SleepUnit/CrushCounter/1.5/gerber/OSFRD-Edge_Cuts.dxf

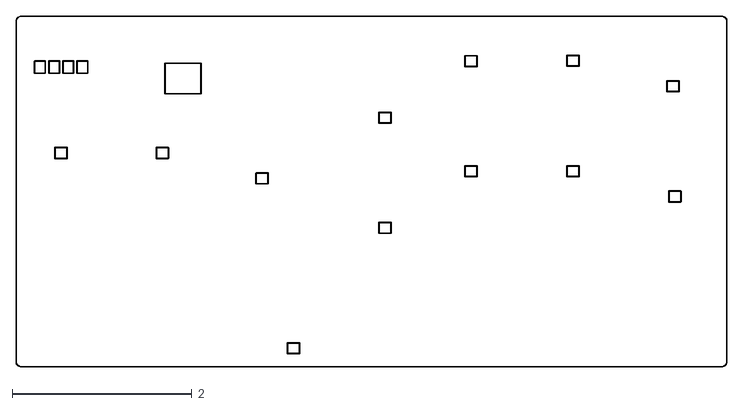
[picture p1: CAD file, 2022-05-07]
1.5/gerber/OSFRD-Edge_Cuts.dxf
7.92 x 3.90
