SleepUnit/CrushCounter/2.0/2.0.step

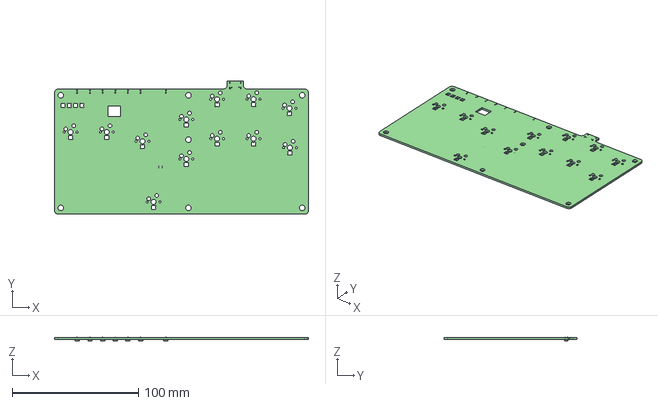
[picture p2: CAD file, 2022-05-07]
2.0/2.0.step
201.0 x 105.6 x 2.80 mm
2.0 PCB
