SleepUnit/CrushCounter/1.5/gerber/OSFRD-B_Cu.dxf

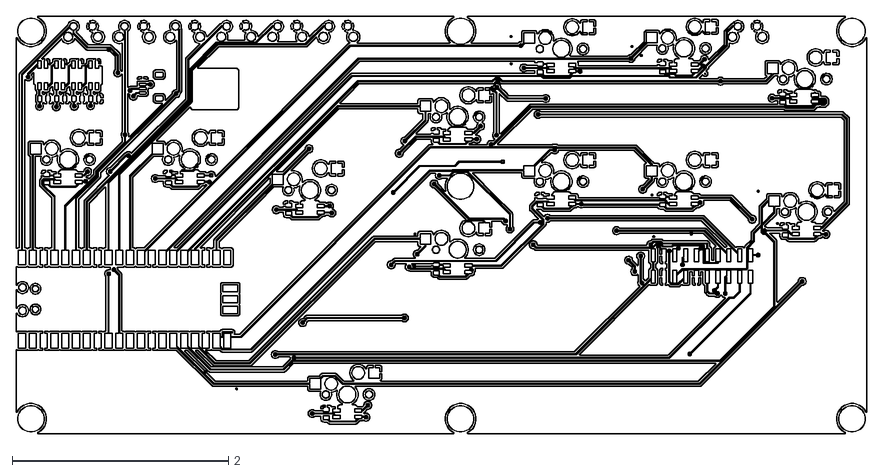
[picture p3: CAD file, 2022-05-07]
1.5/gerber/OSFRD-B_Cu.dxf
7.87 x 3.86
