SleepUnit/CrushCounter/(list of files, cad)

Other CAD files:
1.5/gerber/OSFRD-B_Mask.dxf
1.5/gerber/OSFRD-B_Paste.dxf
1.5/gerber/OSFRD-B_SilkS.dxf
1.5/gerber/OSFRD-F_Mask.dxf
1.5/gerber/OSFRD-F_Paste.dxf
1.5/gerber/OSFRD-F_SilkS.dxf
