SleepUnit/CrushCounter/1.5/OSFRD.kicad_pcb

## KiCad design 1.5/OSFRD.kicad_pcb (2022-05-07)

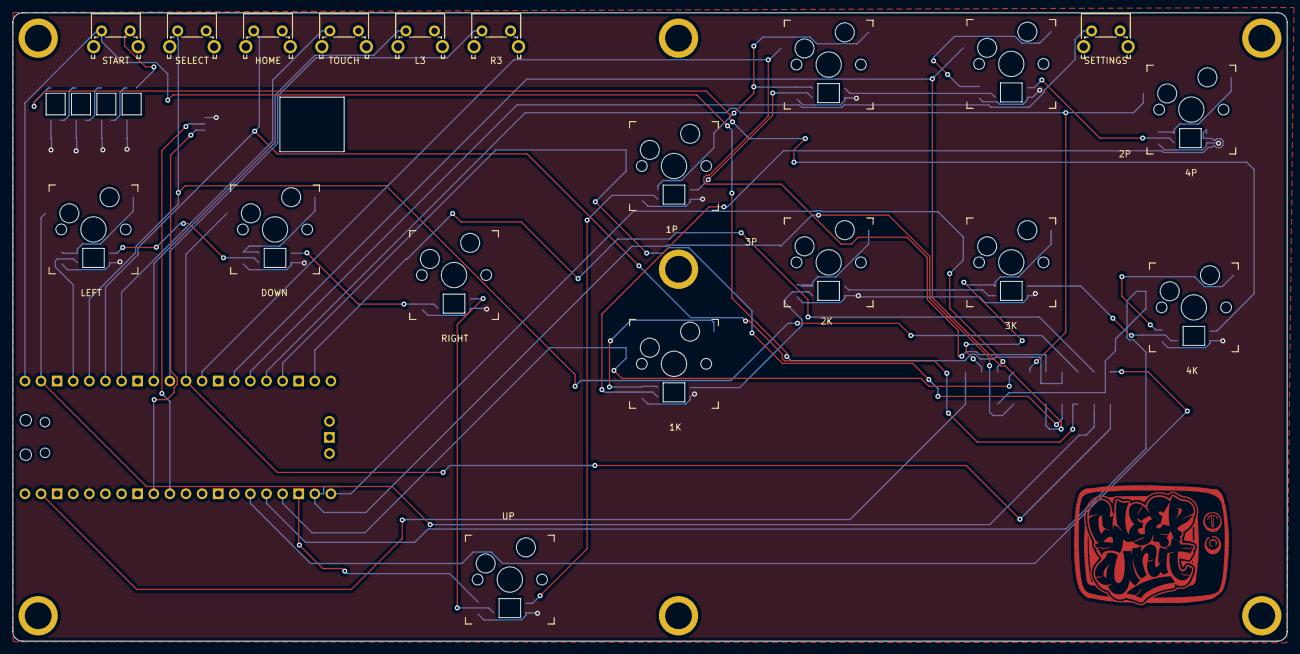
[picture p4: board OSFRD.kicad_pcb from above]

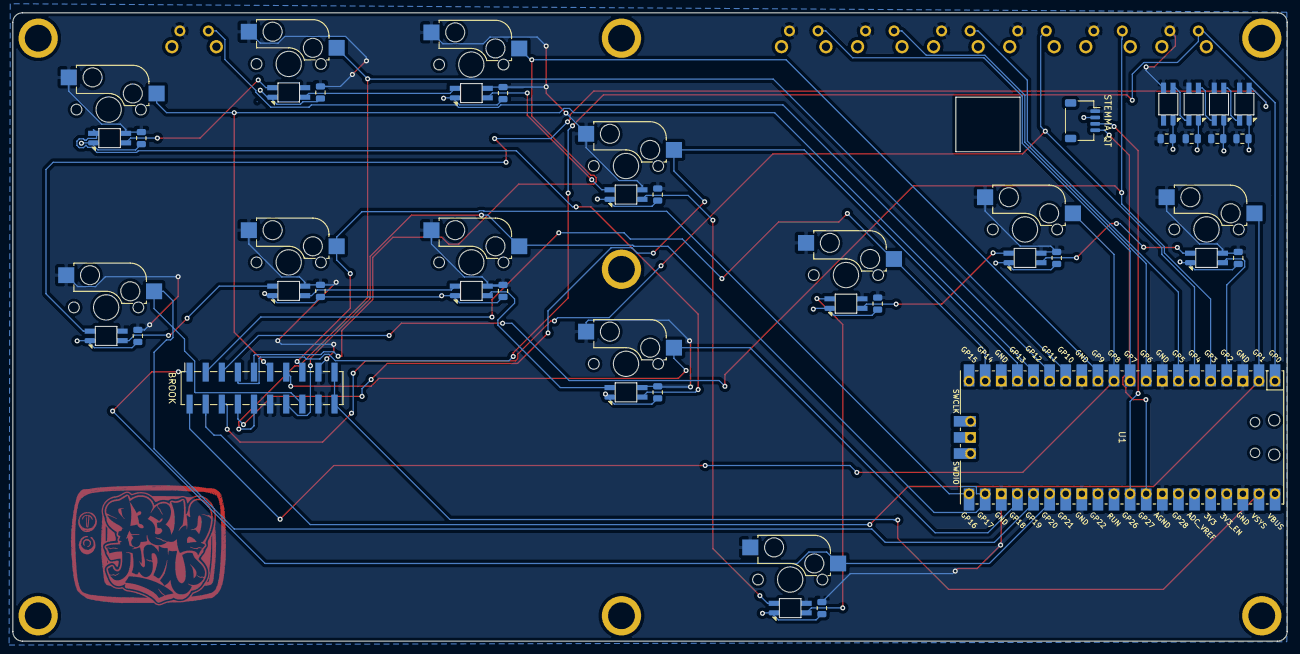
[picture p5: board OSFRD.kicad_pcb from below]

Board: 2 copper layers, 201.0 x 99.1 mm, 54 parts (35 on the bottom side), 40 nets.

Parts:
BROOK: 20 Pin; PinSocket_2x10_P2.54mm_Vertical_SMD
HOME: SW_PUSH; SW_Tactile_SPST_Angled_PTS645Vx83-2LFS
L3: SW_PUSH; SW_Tactile_SPST_Angled_PTS645Vx83-2LFS
R3: SW_PUSH; SW_Tactile_SPST_Angled_PTS645Vx83-2LFS
SELECT: SW_PUSH; SW_Tactile_SPST_Angled_PTS645Vx83-2LFS
SETTINGS: SW_PUSH; SW_Tactile_SPST_Angled_PTS645Vx83-2LFS
START: SW_PUSH; SW_Tactile_SPST_Angled_PTS645Vx83-2LFS
STEMMA QT: STEMMA QT; JST_SH_SM04B-SRSS-TB_1x04-1MP_P1.00mm_Horizontal
SW-P1, SW-P2, SW-P3, SW-P4, SW-P5, SW-P6, SW-P7, SW-P8, SW-P9, SW-P10, SW-P11, SW-P12: KEYSW; Kailh_socket_MX
TOUCH: SW_PUSH; SW_Tactile_SPST_Angled_PTS645Vx83-2LFS
U1: Pico; RPi_Pico_SMD_TH
U-CAP1, U-CAP2, U-CAP3, U-CAP4, U-CAP5, U-CAP6, U-CAP7, U-CAP8, U-CAP9, U-CAP10, U-CAP11, U-CAP12, U-CAP13, U-CAP14, U-CAP15, U-CAP16: 0.1uF; C_0805_2012Metric
U-RGB1, U-RGB2, U-RGB3, U-RGB4, U-RGB5, U-RGB6, U-RGB7, U-RGB8, U-RGB9, U-RGB10, U-RGB11, U-RGB12, U-RGB13, U-RGB14, U-RGB15, U-RGB16: Reverse Mounted NeoPixel; SK6812-MINI-E

Connections:
+3V3: STEMMA QT.2, U1.36, U-CAP1.2, U-CAP2.2, U-CAP3.2, U-CAP4.2, U-CAP5.2, U-CAP6.2, U-CAP7.2, U-CAP8.2, U-CAP9.2, U-CAP10.2, U-CAP11.2, U-CAP12.2, U-CAP13.2, U-CAP14.2, U-CAP15.2, U-CAP16.2, U-RGB1.3, U-RGB2.3, U-RGB3.3, U-RGB4.3, U-RGB5.3, U-RGB6.3, U-RGB7.3, U-RGB8.3, U-RGB9.3, U-RGB10.3, U-RGB11.3, U-RGB12.3, U-RGB13.3, U-RGB14.3, U-RGB15.3, U-RGB16.3
+5V: BROOK.19, BROOK.20, U1.39
/Buttons/sheet61498D2A/DataIn: U-RGB5.4, U-RGB6.2
/Buttons/sheet61498D2B/DataIn: U-RGB6.4, U-RGB7.2
/Buttons/sheet61498D2C/DataIn: U-RGB7.4, U-RGB8.2
/Buttons/sheet61498D2D/DataIn: U-RGB8.4, U-RGB9.2
/Buttons/sheet61498D2E/DataIn: U-RGB9.4, U-RGB10.2
/Buttons/sheet61498D2F/DataIn: U-RGB10.4, U-RGB11.2
/Buttons/sheet61498D25/DataIn: U-RGB1.2, U-RGB4.4
/Buttons/sheet61498D26/DataIn: U-RGB2.2, U-RGB3.4
/Buttons/sheet61498D28/DataIn: U-RGB2.4, U-RGB4.2
/Buttons/sheet61498D29/DataIn: U-RGB1.4, U-RGB5.2
/Buttons/sheet61498D30/DataIn: U-RGB11.4, U-RGB12.2
/GPIO0: BROOK.7, START.1, U1.1
/GPIO1: BROOK.4, SW-P3.2, U1.2
/GPIO2: U1.4, U-RGB3.2
/GPIO3: BROOK.5, SELECT.1, U1.5
/GPIO4: BROOK.6, HOME.1, U1.6
/GPIO5: TOUCH.1, U1.7
/GPIO6: L3.1, U1.9
/GPIO7: R3.1, U1.10
/GPIO8: BROOK.2, SW-P2.2, U1.11
/GPIO9: BROOK.9, SW-P6.2, U1.12
/GPIO10: BROOK.10, SW-P7.2, U1.14
/GPIO11: SETTINGS.1, U1.15
/GPIO12: BROOK.11, SW-P8.2, U1.16
/GPIO13: BROOK.8, SW-P5.2, U1.17
/GPIO14: BROOK.3, SW-P4.2, U1.19
/GPIO16: BROOK.15, SW-P11.2, U1.21
/GPIO17: BROOK.14, SW-P10.2, U1.22
/GPIO18: BROOK.13, SW-P9.2, U1.24
/GPIO19: BROOK.16, SW-P12.2, U1.25
/GPIO20: BROOK.1, SW-P1.2, U1.26
/GPIO26_I2C1_SDA: STEMMA QT.3, U1.31
/GPIO27_I2C1_SCL: STEMMA QT.4, U1.32
/PlayerPixels: U-RGB12.4, U-RGB13.2
GND: BROOK.12, BROOK.17, BROOK.18, HOME.2, L3.2, R3.2, SELECT.2, SETTINGS.2, START.2, STEMMA QT.1, SW-P1.1, SW-P2.1, SW-P3.1, SW-P4.1, SW-P5.1, SW-P6.1, SW-P7.1, SW-P8.1, SW-P9.1, SW-P10.1, SW-P11.1, SW-P12.1, TOUCH.2, U1.3, U1.8, U1.13, U1.18, U1.23, U1.28, U1.33, U1.38, U-CAP1.1, U-CAP2.1, U-CAP3.1, U-CAP4.1, U-CAP5.1, U-CAP6.1, U-CAP7.1, U-CAP8.1, U-CAP9.1, U-CAP10.1, U-CAP11.1, U-CAP12.1, U-CAP13.1, U-CAP14.1, U-CAP15.1, U-CAP16.1, U-RGB1.1, U-RGB2.1, U-RGB3.1, U-RGB4.1, U-RGB5.1, U-RGB6.1, U-RGB7.1, U-RGB8.1, U-RGB9.1, U-RGB10.1, U-RGB11.1, U-RGB12.1, U-RGB13.1, U-RGB14.1, U-RGB15.1, U-RGB16.1
unnamed: U-RGB13.4, U-RGB14.2
unnamed: U-RGB14.4, U-RGB15.2
unnamed: U-RGB15.4, U-RGB16.2
