SleepUnit/CrushCounter/2.0/2.0.kicad_pcb

## KiCad design 2.0/2.0.kicad_pcb (2022-05-07)

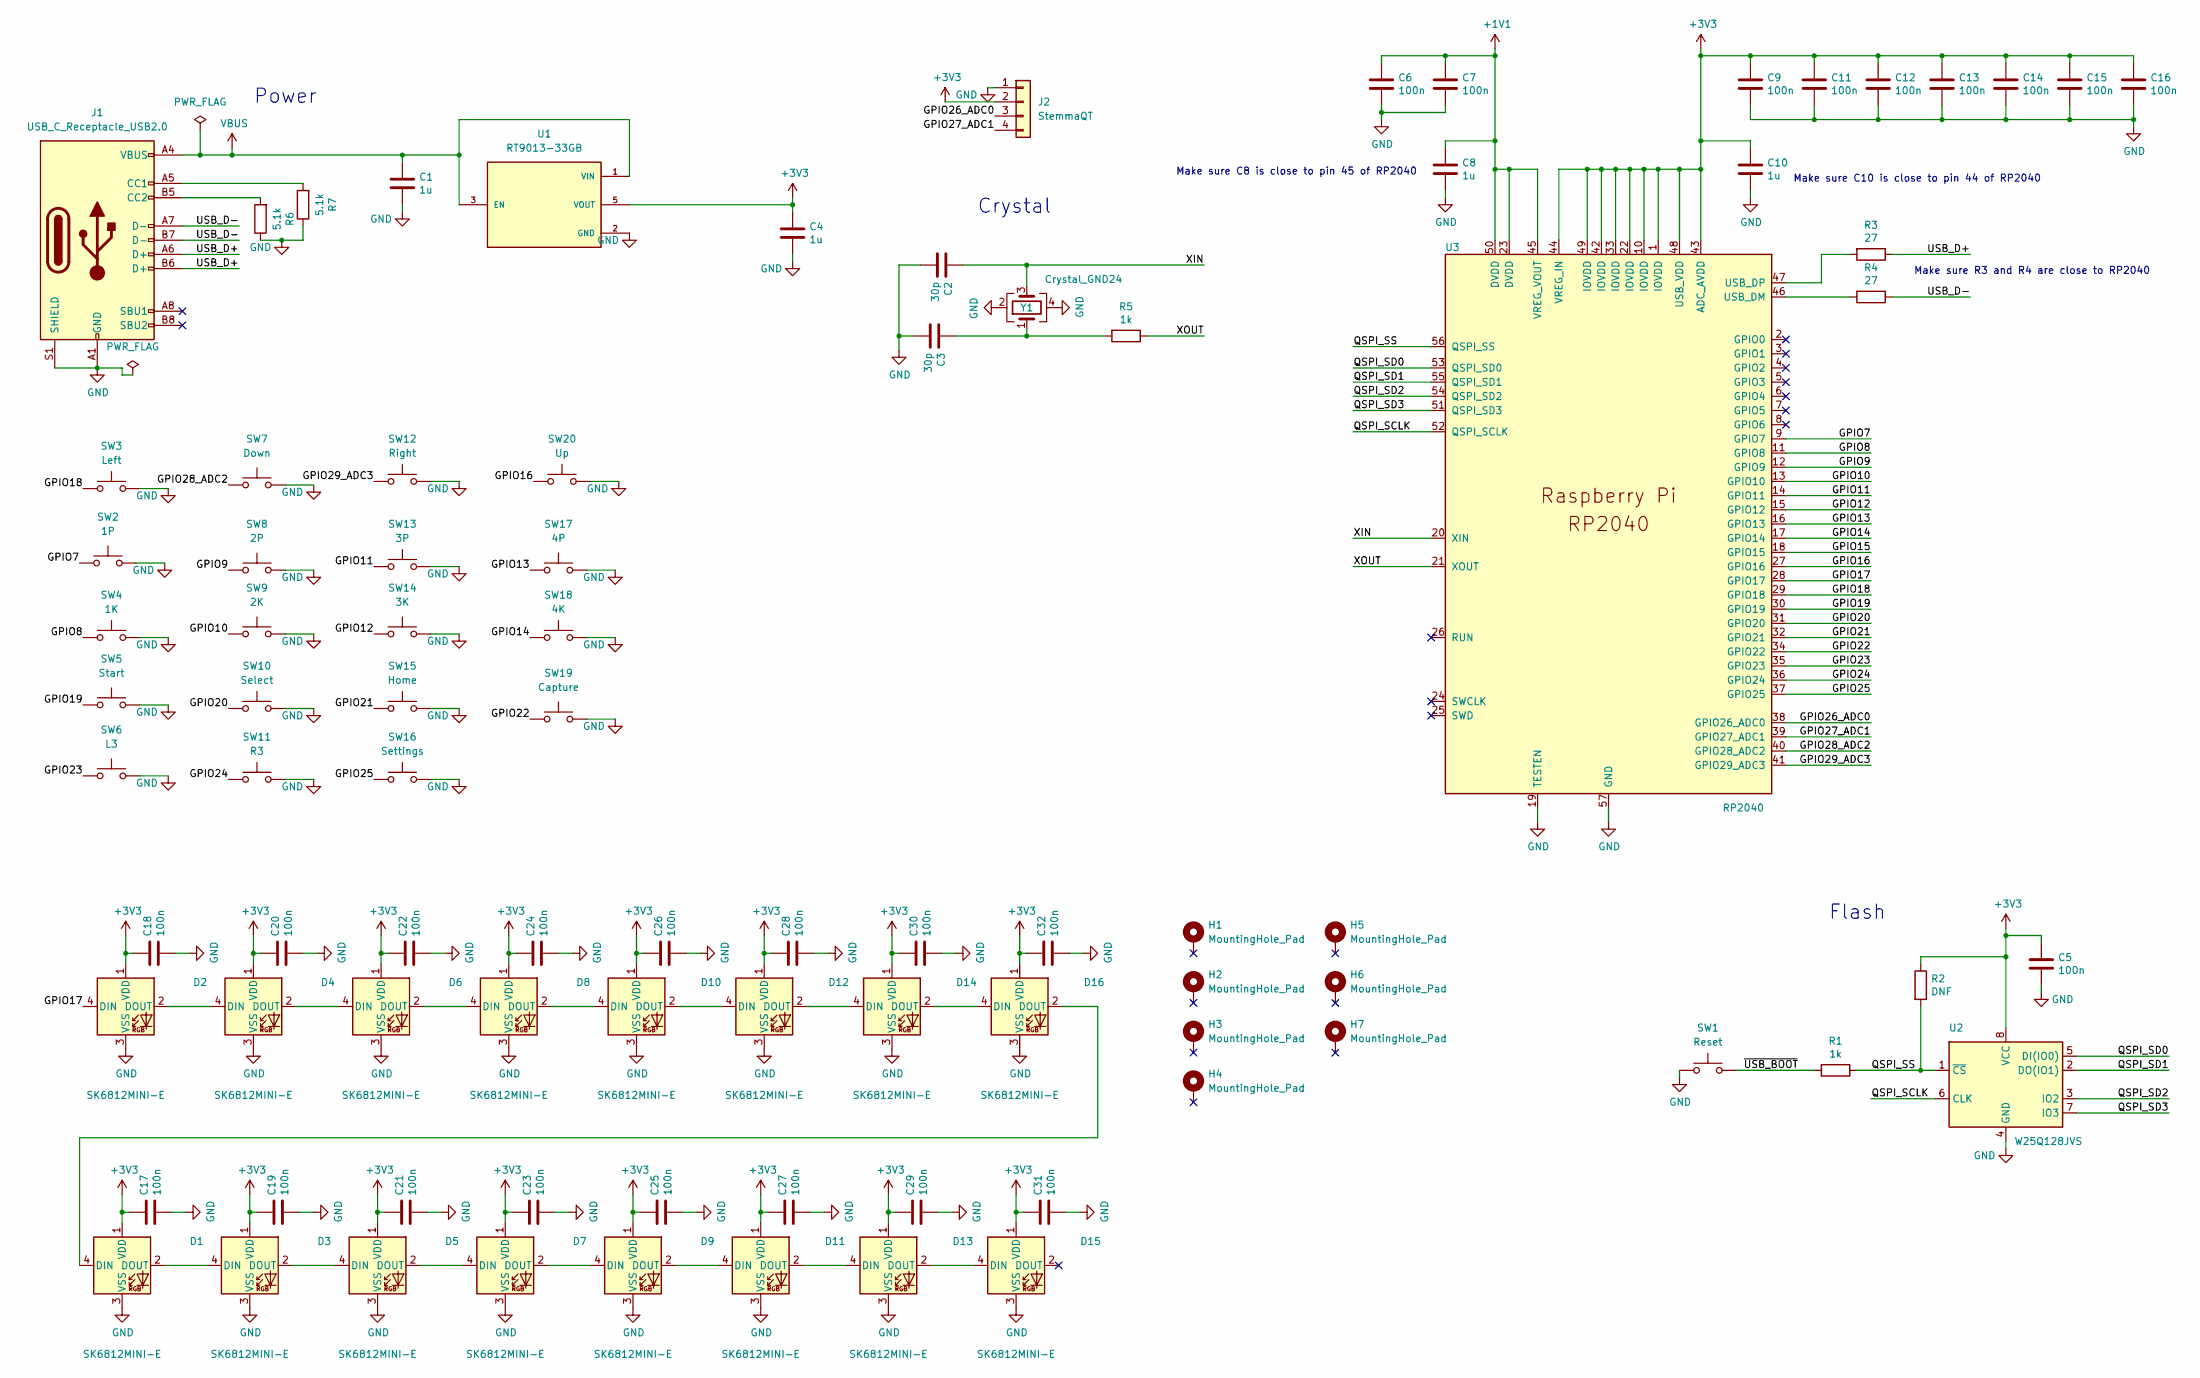
[picture p6: schematic 2.0.kicad_sch, Crush Counter]

Parts:
C1, C4, C8, C10: 1u; C_0402_1005Metric; PartNumber CL05A105KA5NQNC; LCSC Part C52923
C2, C3: 30p; C_0402_1005Metric; PartNumber 0402CG300J500NT; LCSC Part C1570
C5, C6, C7, C9, C11, C12, C13, C14, C15, C16, C17, C18, C19, C20, C21, C22, C23, C24, C25, C26, C27, C28, C29, C30, C31, C32: 100n; C_0402_1005Metric; PartNumber CL05B104KO5NNNC; LCSC Part C1525
D1, D2, D3, D4, D5, D6, D7, D8, D9, D10, D11, D12, D13, D14, D15, D16: SK6812MINI-E; MX_SK6812MINI-E; PartNumber SK6812MINI-E; LCSC Part DNF
H1, H2, H3, H4, H5, H6, H7: MountingHole_Pad; Mounting_Wuerth_WA-SMSI-M3_H2mm_9774020360; PartNumber SMTSO3020MTJ; LCSC Part C2915633
J1: USB_C_Receptacle_USB2.0; USB_C_Receptacle_HRO_TYPE-C-31-M-12; PartNumber HRO_TYPE-C-31-M-12; LCSC Part C165948
J2: StemmaQT; JST_SH_SM04B-SRSS-TB_1x04-1MP_P1.00mm_Horizontal; PartNumber SM04B-SRSS-TBLFSN; LCSC Part DNF
R1, R5: 1k; C_0402_1005Metric; PartNumber 0402WGF1001TCE; LCSC Part C11702
R2: DNF; C_0402_1005Metric; PartNumber DNF; LCSC Part DNF
R3, R4: 27; C_0603_1608Metric; PartNumber 0603WAF270JT5E; LCSC Part C25190
R6, R7: 5.1k; C_0402_1005Metric; PartNumber 0402WGF5101TCE; LCSC Part C25905
SW1: Reset; TS-1187A-B-A-B; PartNumber TS-1187A-B-A-B; LCSC Part C318884
SW2: 1P; Kailh_socket_MX; PartNumber PG151101S11; LCSC Part DNF
SW3: Left; Kailh_socket_MX; PartNumber PG151101S11; LCSC Part DNF
SW4: 1K; Kailh_socket_MX; PartNumber PG151101S11; LCSC Part DNF
SW5: Start; EVQP7C01P; PartNumber EVQP7C01P; LCSC Part C388883
SW6: L3; EVQP7C01P; PartNumber EVQP7C01P; LCSC Part C388883
SW7: Down; Kailh_socket_MX; PartNumber PG151101S11; LCSC Part DNF
SW8: 2P; Kailh_socket_MX; PartNumber PG151101S11; LCSC Part DNF
SW9: 2K; Kailh_socket_MX; PartNumber PG151101S11; LCSC Part DNF
SW10: Select; EVQP7C01P; PartNumber EVQP7C01P; LCSC Part C388883
SW11: R3; EVQP7C01P; PartNumber EVQP7C01P; LCSC Part C388883
SW12: Right; Kailh_socket_MX; PartNumber PG151101S11; LCSC Part DNF
SW13: 3P; Kailh_socket_MX; PartNumber PG151101S11; LCSC Part DNF
SW14: 3K; Kailh_socket_MX; PartNumber PG151101S11; LCSC Part DNF
SW15: Home; EVQP7C01P; PartNumber EVQP7C01P; LCSC Part C388883
SW16: Settings; EVQP7C01P; PartNumber EVQP7C01P; LCSC Part C388883
SW17: 4P; Kailh_socket_MX; PartNumber PG151101S11; LCSC Part DNF
SW18: 4K; Kailh_socket_MX; PartNumber PG151101S11; LCSC Part DNF
SW19: Capture; EVQP7C01P; PartNumber EVQP7C01P; LCSC Part C388883
SW20: Up; Kailh_socket_MX; PartNumber PG151101S11; LCSC Part DNF
U1: RT9013-33GB; SOT94P279X129-5N; PARTREV Aprill 2011; LCSC Part C47773
U2: W25Q128JVS; SOIC-8_5.23x5.23mm_P1.27mm; PartNumber W25Q128JVS; LCSC Part C97521
U3: RP2040; RP2040-QFN-56; PartNumber RP2040; LCSC Part C2040
Y1: Crystal_GND24; Crystal_SMD_3225-4Pin_3.2x2.5mm; PartNumber X322512MSB4SI; LCSC Part C9002

Connections:
+1V1: C6.1, C7.1, C8.1, U3.23 (DVDD), U3.45 (VREG_VOUT), U3.50 (DVDD)
+3V3: C4.1, C5.1, C9.1, C10.1, C11.1, C12.1, C13.1, C14.1, C15.1, C16.1, C17.1, C18.1, C19.1, C20.1, C21.1, C22.1, C23.1, C24.1, C25.1, C26.1, C27.1, C28.1, C29.1, C30.1, C31.1, C32.1, D1.1 (VDD), D2.1 (VDD), D3.1 (VDD), D4.1 (VDD), D5.1 (VDD), D6.1 (VDD), D7.1 (VDD), D8.1 (VDD), D9.1 (VDD), D10.1 (VDD), D11.1 (VDD), D12.1 (VDD), D13.1 (VDD), D14.1 (VDD), D15.1 (VDD), D16.1 (VDD), J2.2, R2.1, U1.5 (VOUT), U2.8 (VCC), U3.1 (IOVDD), U3.10 (IOVDD), U3.22 (IOVDD), U3.33 (IOVDD), U3.42 (IOVDD), U3.43 (ADC_AVDD), U3.44 (VREG_IN), U3.48 (USB_VDD), U3.49 (IOVDD)
/GPIO7: SW2.1, U3.9 (GPIO7)
/GPIO8: SW4.1, U3.11 (GPIO8)
/GPIO9: SW8.1, U3.12 (GPIO9)
/GPIO10: SW9.1, U3.13 (GPIO10)
/GPIO11: SW13.1, U3.14 (GPIO11)
/GPIO12: SW14.1, U3.15 (GPIO12)
/GPIO13: SW17.1, U3.16 (GPIO13)
/GPIO14: SW18.1, U3.17 (GPIO14)
/GPIO15: U3.18 (GPIO15)
/GPIO16: SW20.1, U3.27 (GPIO16)
/GPIO17: D2.4 (DIN), U3.28 (GPIO17)
/GPIO18: SW3.1, U3.29 (GPIO18)
/GPIO19: SW5.1, U3.30 (GPIO19)
/GPIO20: SW10.1, U3.31 (GPIO20)
/GPIO21: SW15.1, U3.32 (GPIO21)
/GPIO22: SW19.1, U3.34 (GPIO22)
/GPIO23: SW6.1, U3.35 (GPIO23)
/GPIO24: SW11.1, U3.36 (GPIO24)
/GPIO25: SW16.1, U3.37 (GPIO25)
/GPIO26_ADC0: J2.3, U3.38 (GPIO26_ADC0)
/GPIO27_ADC1: J2.4, U3.39 (GPIO27_ADC1)
/GPIO28_ADC2: SW7.1, U3.40 (GPIO28_ADC2)
/GPIO29_ADC3: SW12.1, U3.41 (GPIO29_ADC3)
/QSPI_SCLK: U2.6 (CLK), U3.52 (QSPI_SCLK)
/QSPI_SD0: U2.5 (DI(IO0)), U3.53 (QSPI_SD0)
/QSPI_SD1: U2.2 (DO(IO1)), U3.55 (QSPI_SD1)
/QSPI_SD2: U2.3 (IO2), U3.54 (QSPI_SD2)
/QSPI_SD3: U2.7 (IO3), U3.51 (QSPI_SD3)
/QSPI_SS: R1.1, R2.2, U2.1 (~CS), U3.56 (QSPI_SS)
/USB_D+: J1.A6 (D+), J1.B6 (D+), R3.1
/USB_D-: J1.A7 (D-), J1.B7 (D-), R4.1
/XIN: C2.1, U3.20 (XIN), Y1.3
/XOUT: R5.1, U3.21 (XOUT)
/~USB_BOOT: R1.2, SW1.2
GND: C1.2, C2.2, C3.2, C4.2, C5.2, C6.2, C7.2, C8.2, C9.2, C10.2, C11.2, C12.2, C13.2, C14.2, C15.2, C16.2, C17.2, C18.2, C19.2, C20.2, C21.2, C22.2, C23.2, C24.2, C25.2, C26.2, C27.2, C28.2, C29.2, C30.2, C31.2, C32.2, D1.3 (VSS), D2.3 (VSS), D3.3 (VSS), D4.3 (VSS), D5.3 (VSS), D6.3 (VSS), D7.3 (VSS), D8.3 (VSS), D9.3 (VSS), D10.3 (VSS), D11.3 (VSS), D12.3 (VSS), D13.3 (VSS), D14.3 (VSS), D15.3 (VSS), D16.3 (VSS), J1.A1 (GND), J1.A12 (GND), J1.B1 (GND), J1.B12 (GND), J1.S1 (SHIELD), J2.1, R6.1, R7.1, SW1.1, SW2.2, SW3.2, SW4.2, SW5.2, SW6.2, SW7.2, SW8.2, SW9.2, SW10.2, SW11.2, SW12.2, SW13.2, SW14.2, SW15.2, SW16.2, SW17.2, SW18.2, SW19.2, SW20.2, U1.2 (GND), U2.4 (GND), U3.19 (TESTEN), U3.57 (GND), Y1.2, Y1.4
unnamed: C3.1, R5.2, Y1.1
unnamed: D1.2 (DOUT), D3.4 (DIN)
unnamed: D1.4 (DIN), D16.2 (DOUT)
unnamed: D2.2 (DOUT), D4.4 (DIN)
unnamed: D3.2 (DOUT), D5.4 (DIN)
unnamed: D4.2 (DOUT), D6.4 (DIN)
unnamed: D5.2 (DOUT), D7.4 (DIN)
unnamed: D6.2 (DOUT), D8.4 (DIN)
unnamed: D7.2 (DOUT), D9.4 (DIN)
unnamed: D10.2 (DOUT), D12.4 (DIN)
unnamed: D8.2 (DOUT), D10.4 (DIN)
unnamed: D11.2 (DOUT), D13.4 (DIN)
unnamed: D9.2 (DOUT), D11.4 (DIN)
unnamed: D12.2 (DOUT), D14.4 (DIN)
unnamed: D13.2 (DOUT), D15.4 (DIN)
unnamed: D14.2 (DOUT), D16.4 (DIN)
unnamed: J1.A5 (CC1), R7.2
unnamed: J1.B5 (CC2), R6.2
unnamed: R3.2, U3.47 (USB_DP)
unnamed: R4.2, U3.46 (USB_DM)
VBUS: C1.1, J1.A4 (VBUS), J1.A9 (VBUS), J1.B4 (VBUS), J1.B9 (VBUS), U1.1 (VIN), U1.3 (EN)

Notes on the sheet:
Make sure C10 is close to pin 44 of RP2040
Power
Flash
Make sure R3 and R4 are close to RP2040
Make sure C8 is close to pin 45 of RP2040
Crystal

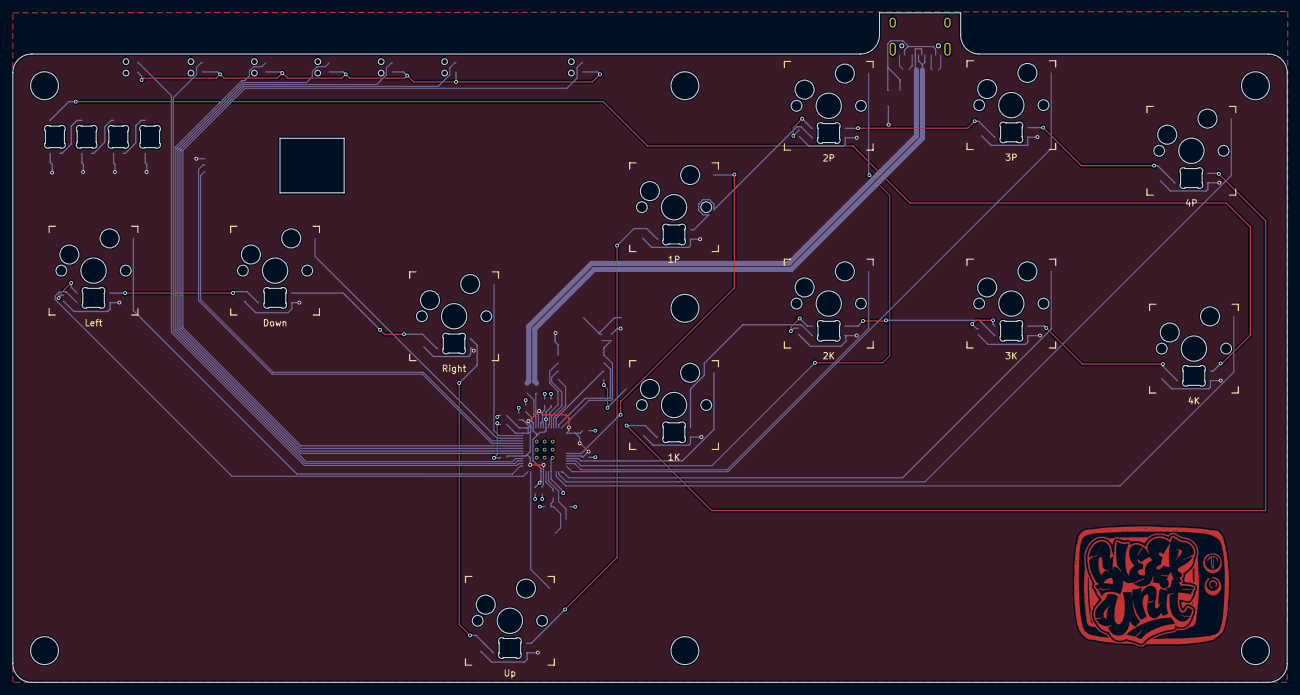
[picture p7: board 2.0.kicad_pcb from above]

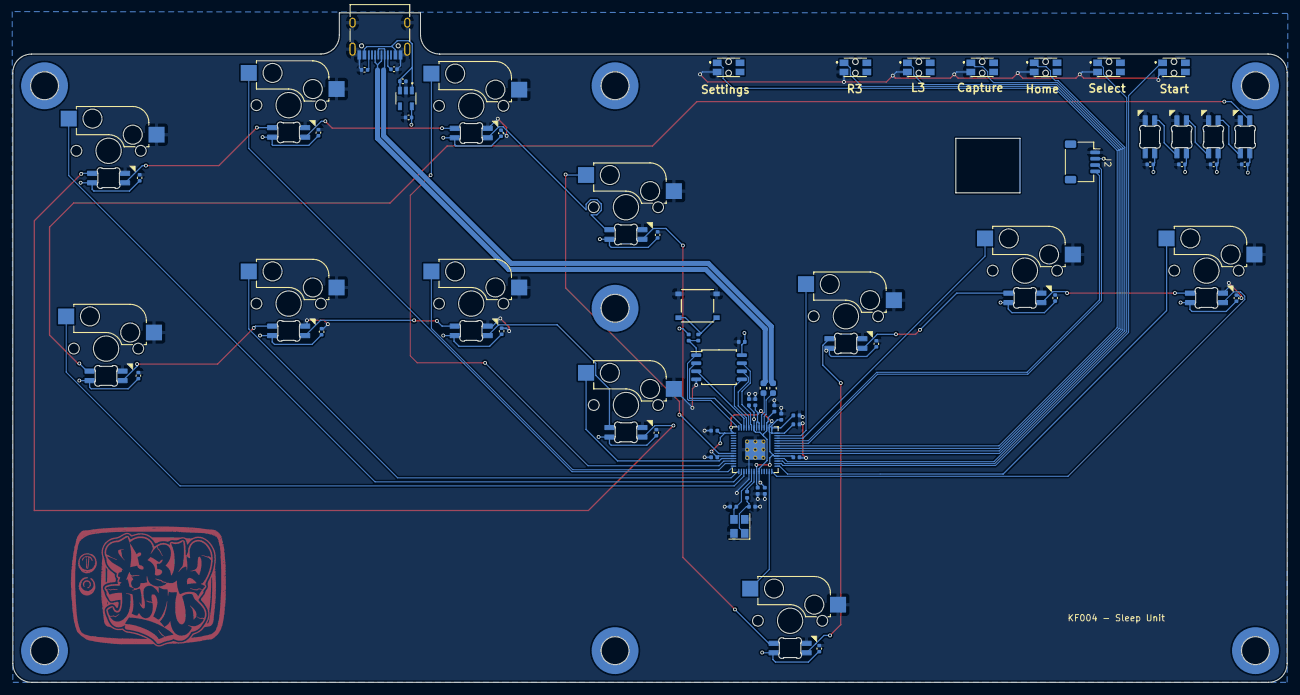
[picture p8: board 2.0.kicad_pcb from below]

Board: 2 copper layers, 201.0 x 105.6 mm, 88 parts (76 on the bottom side), 57 nets.
