SleepUnit/CrushCounter/(commit log)

2021-09-02 Initial Public Release of In Progress OSFRDv2
    [Buttons.sch, Crystal.sch, Flash.sch, MCU.sch, OSFRD.kicad_pcb, OSFRD.sch, PlayerLEDs.sch, Power.sch]
2021-09-15 v1.5 Finalized
    [Buttons.sch, Crystal.sch, Flash.sch, MCU.sch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]
2021-10-29 Docs for the v1.5
    [OSFRD-B_Cu.dxf, OSFRD-B_Mask.dxf, OSFRD-B_Paste.dxf, OSFRD-B_SilkS.dxf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]
2022-05-07 Added 2.0 finally
    [2.0-CmtUser.gbr, 2.0-CuBottom.gbl, 2.0-CuTop.gtl, 2.0-EdgeCuts.gm1, 2.0-MaskBottom.gbs, 2.0-MaskTop.gts, 2.0-NPTH.drl, 2.0-PTH.drl]
